synergia/synermycha-electronics/README.md

View this project on [CADLAB.io](https://cadlab.io/project/23388). 

# synermycha-electronics
