synergia/synermycha-electronics/3D_models/VL53L0X.STEP

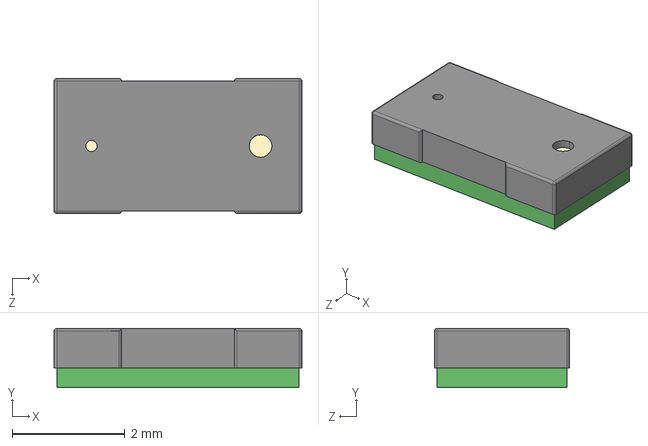
[picture p1: CAD file, 2020-03-10]
3D_models/VL53L0X.STEP
4.40 x 1.05 x 2.40 mm
