synergia/synermycha-electronics/as5045b_board/as5045b_board_left.step

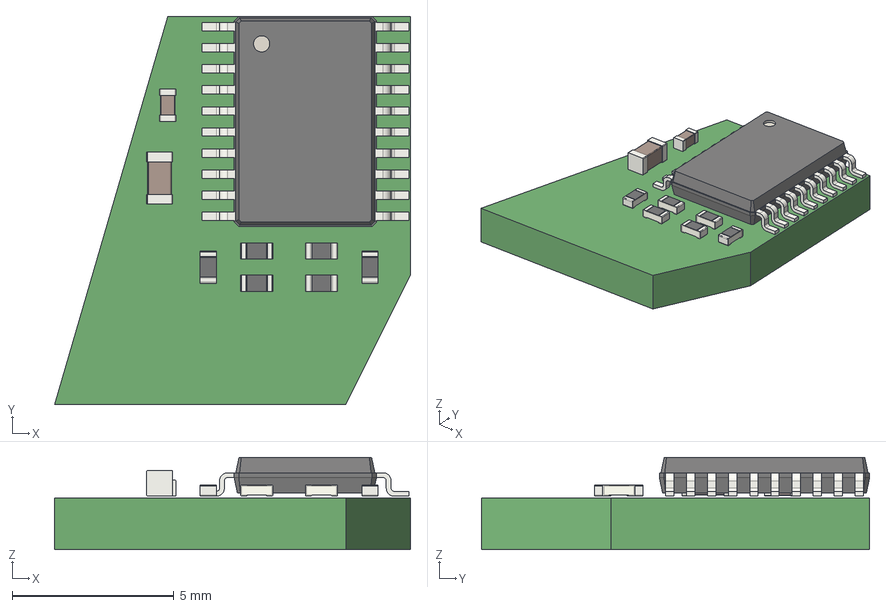
[picture p2: CAD file, 2020-03-10]
as5045b_board/as5045b_board_left.step
11.0 x 12.0 x 2.85 mm
