synergia/synermycha-electronics/3D_models/SynerMycha-silnikii.stp

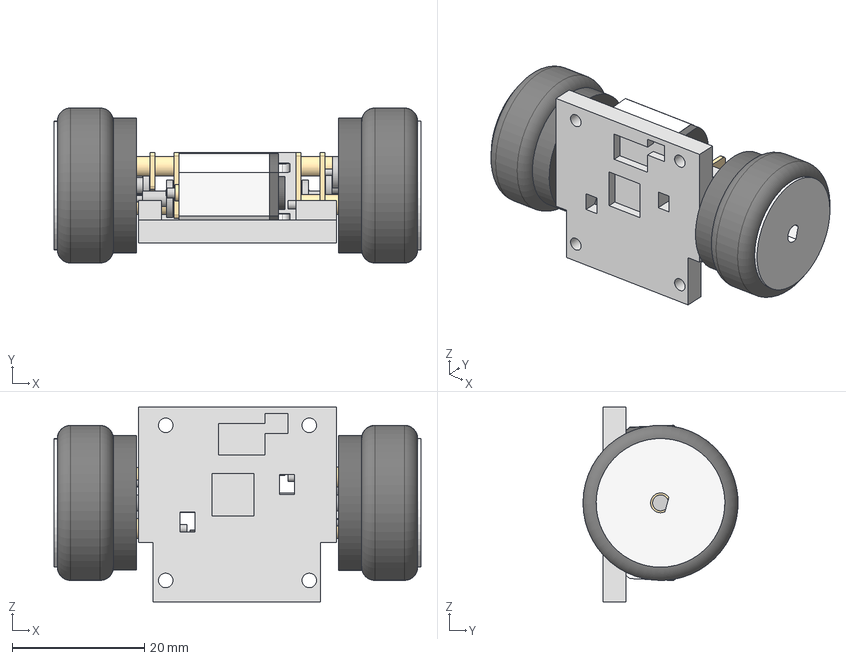
[picture p3: CAD file, 2020-03-10]
3D_models/SynerMycha-silnikii.stp
55.6 x 23.5 x 29.5 mm
GearboxScaffolding x 2
DC Motor x 2
Felga x 2
Tyre x 2
MWR0032KAC-KH x 2
podstawa_silnikó
