synergia/synermycha-electronics/vl53l0_board/vl53l0.STEP

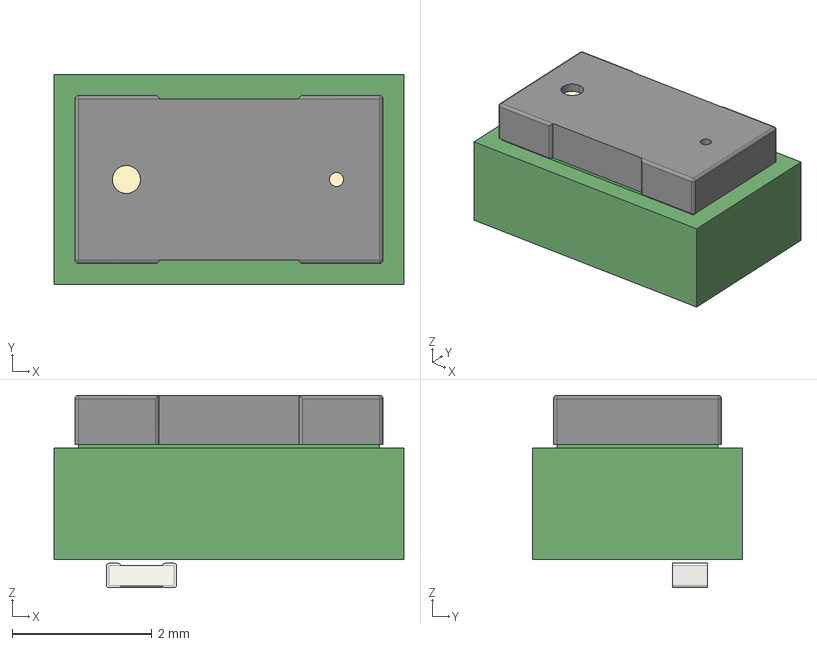
[picture p4: CAD file, 2020-03-10]
vl53l0_board/vl53l0.STEP
5.00 x 3.00 x 2.75 mm
