synergia/synermycha-electronics/3D_models/FTSH-107-01-L-DV-K-TR.stp

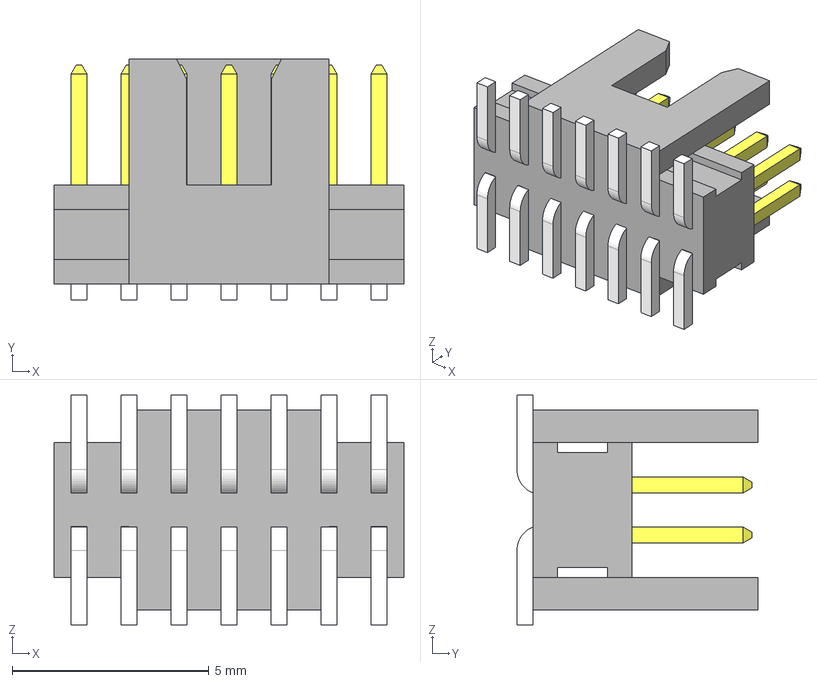
[picture p5: CAD file, 2020-03-10]
3D_models/FTSH-107-01-L-DV-K-TR.stp
8.89 x 6.12 x 5.84 mm
_FTSH-107-01-L-DV-K-TR_body
_FTSH-107-01-L-DV-K-TR_pins1
_FTSH-107-01-L-DV-K-TR_pins2
