synergia/synermycha-electronics/3D_models/User Library-R-PWSON-N12.step

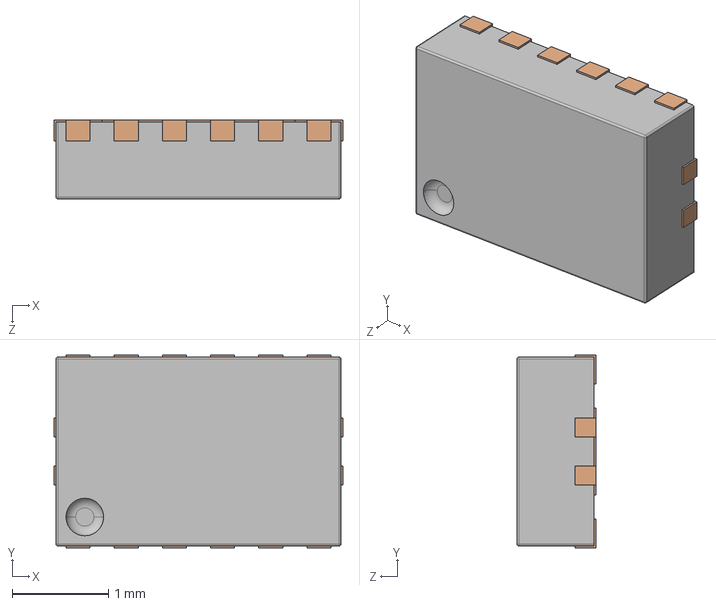
[picture p6: CAD file, 2020-03-10]
3D_models/User Library-R-PWSON-N12.step
3.00 x 2.00 x 0.82 mm
