synergia/synermycha-electronics/3D_models/MPU9250.step

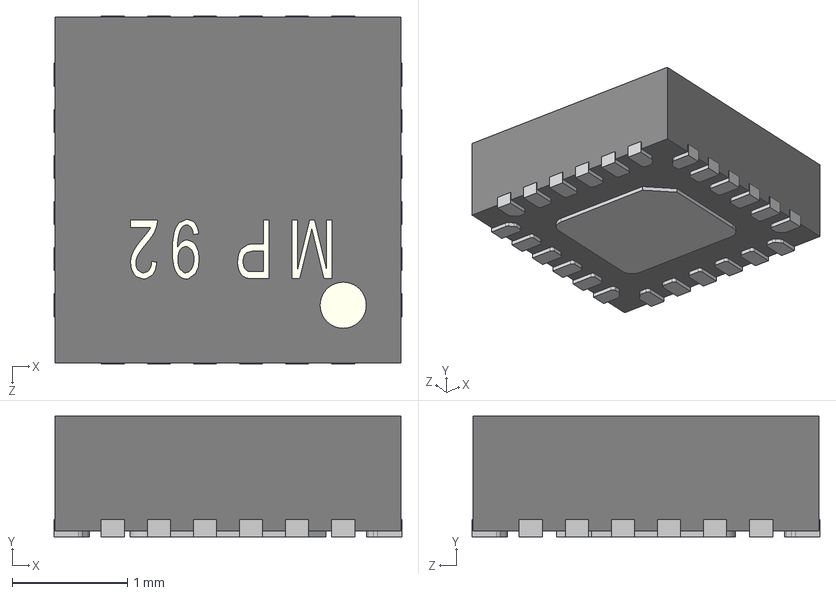
[picture p7: CAD file, 2020-03-10]
3D_models/MPU9250.step
3.02 x 1.05 x 3.02 mm
