synergia/synermycha-electronics/3D_models/CMT-5023S-SMT-TR.stp

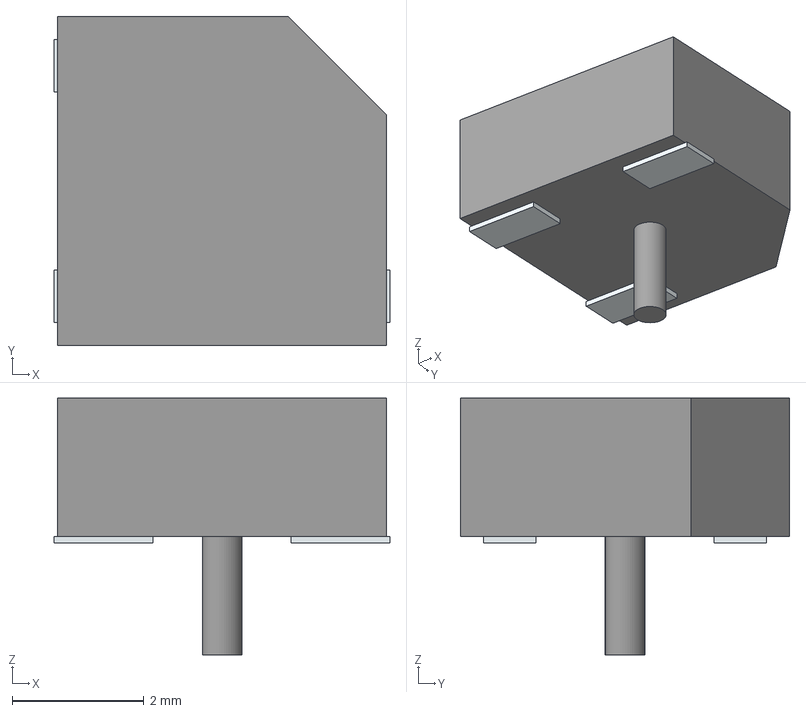
[picture p8: CAD file, 2020-03-10]
3D_models/CMT-5023S-SMT-TR.stp
5.10 x 5.00 x 3.90 mm
('pin',_'1')
('pin',_'2')
('pin',_'3')
lug1
