synergia/synermycha-electronics/3D_models/ABM8G-12.000MHZ-4Y-T3--3DModel-STEP-56544.STEP

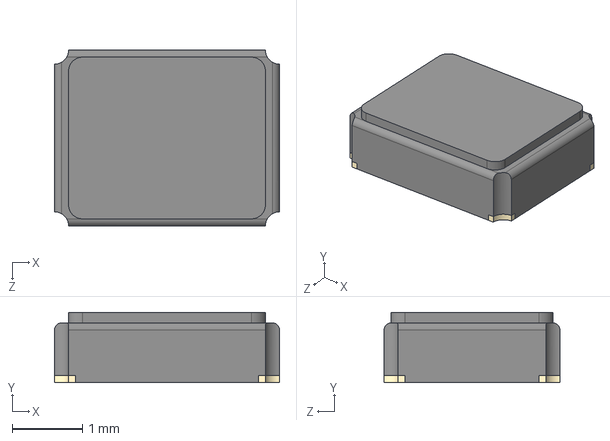
[picture p9: CAD file, 2020-03-10]
3D_models/ABM8G-12.000MHZ-4Y-T3--3DModel-STEP-56544.STEP
3.20 x 1.00 x 2.50 mm
