synergia/synermycha-electronics/3D_models/DF13C-4P-1.25V.step

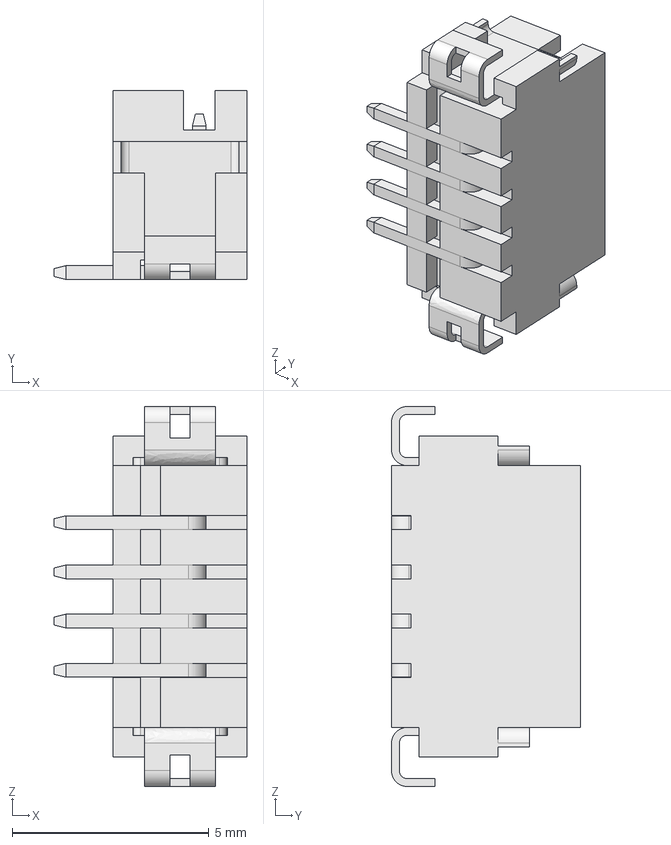
[picture p10: CAD file, 2020-03-10]
3D_models/DF13C-4P-1.25V.step
4.90 x 4.80 x 9.65 mm
