synergia/synermycha-electronics/3D_models/WS2812-2020.stp

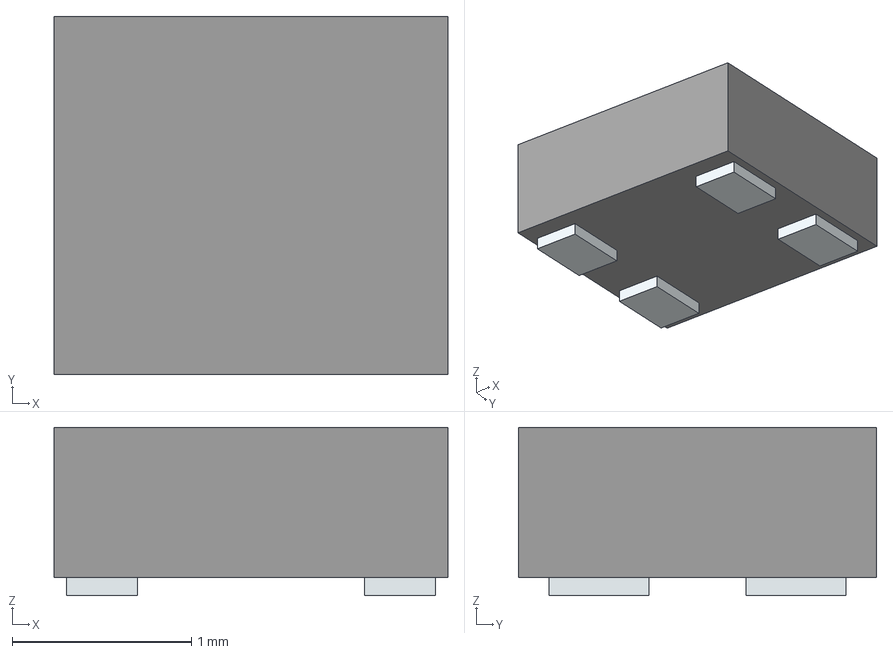
[picture p11: CAD file, 2020-03-10]
3D_models/WS2812-2020.stp
2.20 x 2.00 x 0.94 mm
('pin',_'1')
('pin',_'2')
('pin',_'3')
('pin',_'4')
