synergia/synermycha-electronics/3D_models/mocowanie-napędów.stp

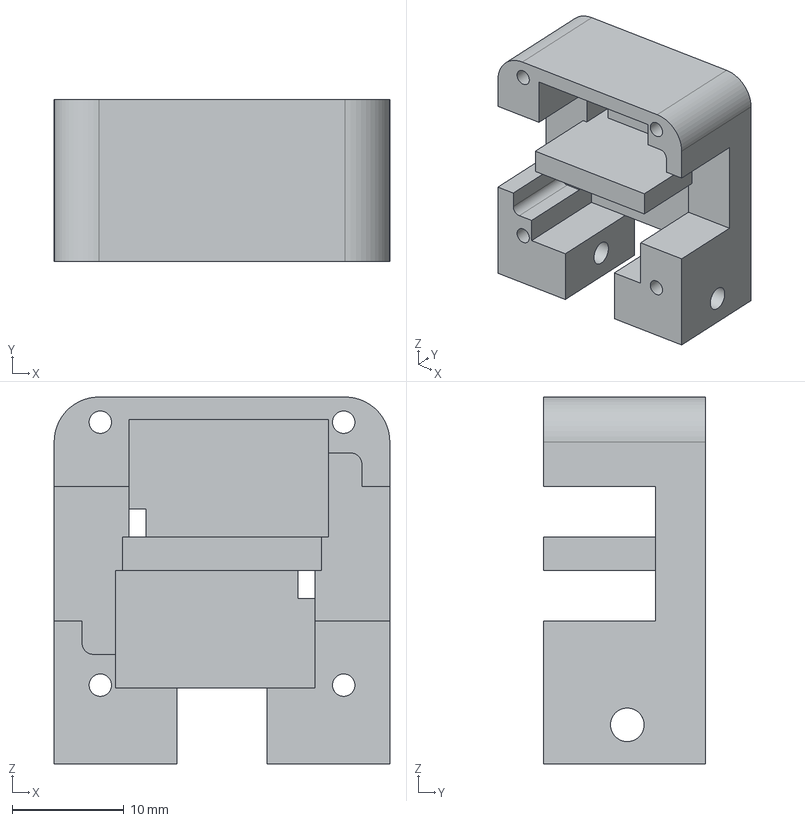
[picture p12: CAD file, 2020-03-10]
3D_models/mocowanie-napędów.stp
30.0 x 14.5 x 32.8 mm
