synergia/synermycha-electronics/3D_models/JS102011SAQN.STEP

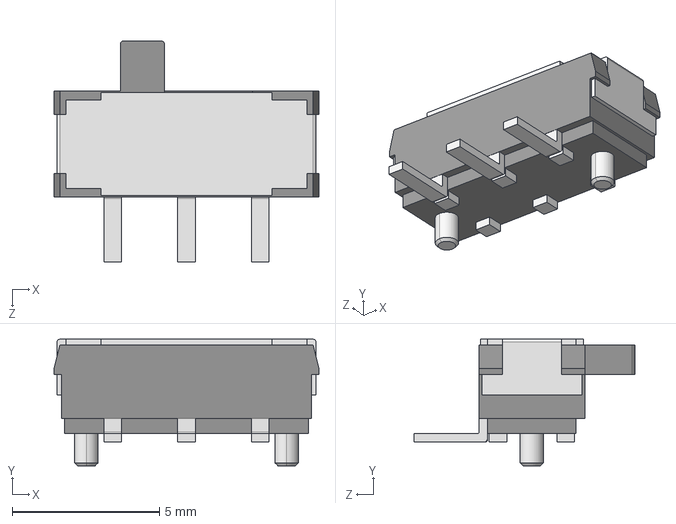
[picture p13: CAD file, 2020-03-10]
3D_models/JS102011SAQN.STEP
9.00 x 4.30 x 7.50 mm
