synergia/synermycha-electronics/(list of files, cad)

Other CAD files:
as5045b_board/as5045b_board_right.step
