synergia/synermycha-electronics/(threads)

Thread 1 (2020-03-07):

FSYNC pin wisi

bartek1333, 2020-03-07:
W DS do IMU:
FSYNC Frame synchronization digital input. Connect to GND if unused.
Na schemacie wisi

Frzoen, 2020-03-07:
Fixed in [commit](https://github.com/synergia/synermycha-electronics/commit/8cd587369a88bf1a04ddcbafc6c34fccc7df5dc4)

Closed 2020-03-07.

Thread 11 (2020-03-07):

Dodatkowy kondensator 100uF na linii 6V

bartek1333, 2020-03-07:
Trzeba dodać kondensator 100nF (z DS) do pinu VM

Frzoen, 2020-03-07:
Fixed in [https://github.com/synergia/synermycha-electronics/commit/8cd587369a88bf1a04ddcbafc6c34fccc7df5dc4](commit)

bartek1333, 2020-03-08:
In DS example is 100nF, not 100uF

Frzoen, 2020-03-08:
Na przykładowym układzie nie ma nic o 0.1uF na VM. 0.1uF nic nie da na wejściu mostka, za duże prądy przepływają. Można pomyśleć nad jakimiś kondensatorami na pinach silników. 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

bartek1333, 2020-03-08:
Nie wiem co to jest za przykładowy schemat, ale ten poniżej jest z DS:
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

Frzoen, 2020-03-08:
Fixed in [commit](https://github.com/synergia/synermycha-electronics/commit/1e9b78f6cea6090ee7997e9f168c55b7f5af0730)

Closed 2020-03-08.

Thread 12 (2020-03-07):

Połączenie z czujnikiem XSHUT

bartek1333, 2020-03-07:
W sumie o tym już gadaliśmy, ale napisze. Procek powinien na spokojnie sterować pinem xshut nawet jeśli jest podłączony do 2.8V (zwierać do masy w trybie open drain).
Odpada wtedy 1 rezystor i 2 napięcia koło siebie na jednej linii

Frzoen, 2020-03-07:
DS do VC53L0x zaleca napięcie 2.8 i napięcie na pinach XSHUT powinno być takie jak zasilające. Poza tym można pominąć wlutowanie rezystorów i zastąpić je 0R i wyjdzie na to samo.

bartek1333, 2020-03-07:
Który rezystor chcesz zastąpić przez 0R że wyjdzie to samo?
Jak będzie open drain i rezystor do 2.8V, to będzie zgodnie z DS, 0-2.8

Frzoen, 2020-03-07:
Zwarcie padów dwóch rezystorów. Da się wykonać w obecnym układnie

bartek1333, 2020-03-07:
Tak czy inaczej, będzie to trzeba sterować z open drain, a nie push-pull, bo na xshut pójdzie 3.3. Więc po co kombinować z dwoma napięciami.

Frzoen, 2020-03-07:
Wontfix

bartek1333, 2020-03-07:
Sam napisałeś że tam ma być 2.8V.
Sprawdź w symulacji, że tam wyjdzie 3.3

Frzoen, 2020-03-07:
Wciąż, da się wykonać na aktualnym schemacie, przykładowo R38 0R albo zwora. Ten układ jest w dokumentacji do modułów Polulu z którymi Arduino 5V czy Nucleo 3V3 bez problemu się komunikują.

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

bartek1333, 2020-03-08:
Co Ci da zastąpienie R38 zworą czy 0R?

Cytat ze strony https://www.pololu.com/product/2490

The XSHUT pin is an input and the GPIO1 pin is an open-drain output; both pins are pulled up to 2.8 V by the board. They are not connected to level-shifters on the board and are not 5V-tolerant, but they are usable as-is with many 3.3 V and 5 V microcontrollers: the microcontroller can read the GPIO1 output as long as its logic high threshold is below 2.8 V, and the microcontroller can alternate its own output between low and high-impedance states to drive the XSHUT pin. Alternatively, our 4-channel bidirectional logic level shifter can be used externally with those pins.

Więc komunikują się z nim procki 3.3V i 5V tylko dlatego, że ma wbudowany na liniach I2C logic level shifter. Natomiast już sterowanie pinem XSHOUT nie jest takie proste bo na płytce (i na naszym schemacie) nie ma konwertera napięć. I jedyne co procek może zrobić to zwierać do GND lub wisieć w powietrzu, żeby nie dać 3.3 lub 5V na układ.
Dlatego to 3.3V tam nie powinno być, bo w symulacji wychodzi, że na XSHOUT będzie szło 3.3V gdy na wyjściu procka będzie logiczne 1 (push pull). Przy open drain bez ściągania do masy, też na xshout będzie ponad 3V.

Dlatego to 3.3V trzeba usunąć. Procki o których pisałeś komunikują się z tym, nie wystawiając 1-0 na linie, tylko zwierając albo do masy, albo float.

Frzoen, 2020-03-08:
Fixed in [commit](https://github.com/synergia/synermycha-electronics/commit/1e9b78f6cea6090ee7997e9f168c55b7f5af0730)

Closed 2020-03-08.

Thread 2 (2020-03-07):

CS pin

bartek1333, 2020-03-07:
Pin CS jest do vdd bezpośrednio w DS, na schemacie przez rezystorem

Frzoen, 2020-03-07:
Rezystor zabezpiecza układ. Dobra praktyka - podciąganie do VCC/GND za pomocą rezystora

Closed 2020-03-07.

Thread 3 (2020-03-07):

RESVCC RESGND

bartek1333, 2020-03-07:
Piny resv_GDN wisi a powinno być do GND, tak samo Res_VCC do vcc

Frzoen, 2020-03-07:
Fixed in [commit](https://github.com/synergia/synermycha-electronics/commit/8cd587369a88bf1a04ddcbafc6c34fccc7df5dc4)

Closed 2020-03-07.

Thread 4 (2020-03-07):

pull up I2C

bartek1333, 2020-03-07:
Pull-Up dla 3.3V ok 2k7, nie 10k. Nad 2.8V trzeba rozkminić

Frzoen, 2020-03-07:
2K7 będzie dobre też dla 2.8V a nie dodajemy kolejnej wielkości rezystora do BOM

Frzoen, 2020-03-07:
Fixed in [commit](https://github.com/synergia/synermycha-electronics/commit/8cd587369a88bf1a04ddcbafc6c34fccc7df5dc4)

Closed 2020-03-07.

Thread 6 (2020-03-07):

zamiana polaryzacji led przy VL53L0

bartek1333, 2020-03-07:
Zmienić na schemacie polaryzacje diody przy czujnikach. Niby to schemat, ale niech już będzie ok xD

Frzoen, 2020-03-07:
Fixed in [commit](https://github.com/synergia/synermycha-electronics/commit/8cd587369a88bf1a04ddcbafc6c34fccc7df5dc4)

Closed 2020-03-07.

Thread 8 (2020-03-07):

zmiana wartości rezystora przy LM1117 6V

bartek1333, 2020-03-07:
Policzyłem i bliższą wartością dla 6V na wyjściu, będzie wstawienie zamiast 3k16, to 3k32 z szeregu E192 (0.5%)

Frzoen, 2020-03-07:
Fixed in [commit](https://github.com/synergia/synermycha-electronics/commit/8cd587369a88bf1a04ddcbafc6c34fccc7df5dc4)

Closed 2020-03-07.

Thread 13 (2020-03-09):

Brak pull-up na XSHOUT

bartek1333, 2020-03-09:
Dołożyć pull up na 2.8V na każdy xshout

Frzoen, 2020-03-10:
Fixed in [commit](https://github.com/synergia/synermycha-electronics/commit/6721a22e7ced20e5ca89c9b0f47a4a8e833ebf07)

Closed 2020-03-10.

Thread 14 (2020-03-10):

Odwrotna polaryzacja diody  LED_MOUSE_EYE

bartek1333, 2020-03-10:
Jak w temacie

Frzoen, 2020-03-10:
Fixed in [commit](https://github.com/synergia/synermycha-electronics/tree/3e133a07d852ece3ec825dd7d51c8af7a5921581)

Closed 2020-03-10.
