synergia/synermycha-electronics/synermycha-electronics.kicad_pcb

## KiCad design synermycha-electronics.kicad_pcb (2020-08-28)

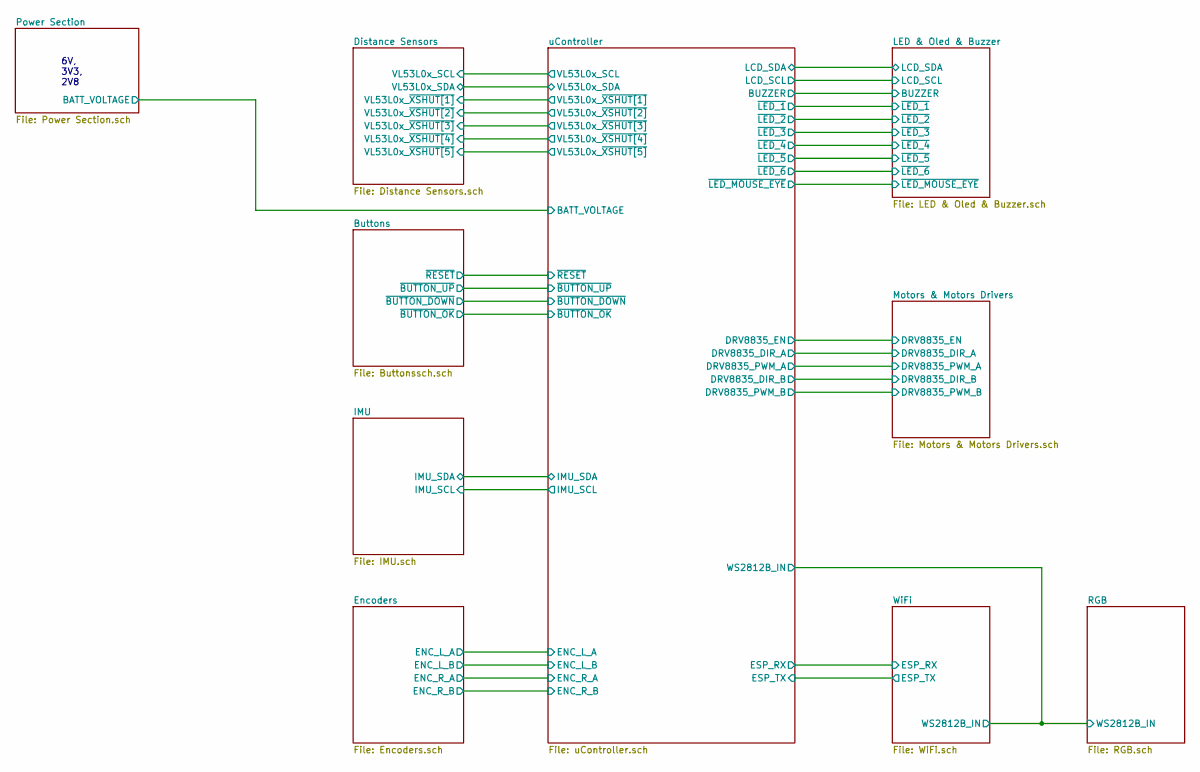
[picture p14: schematic synermycha-electronics.sch]

Notes on the sheet:
6V, 3V3, 2V8

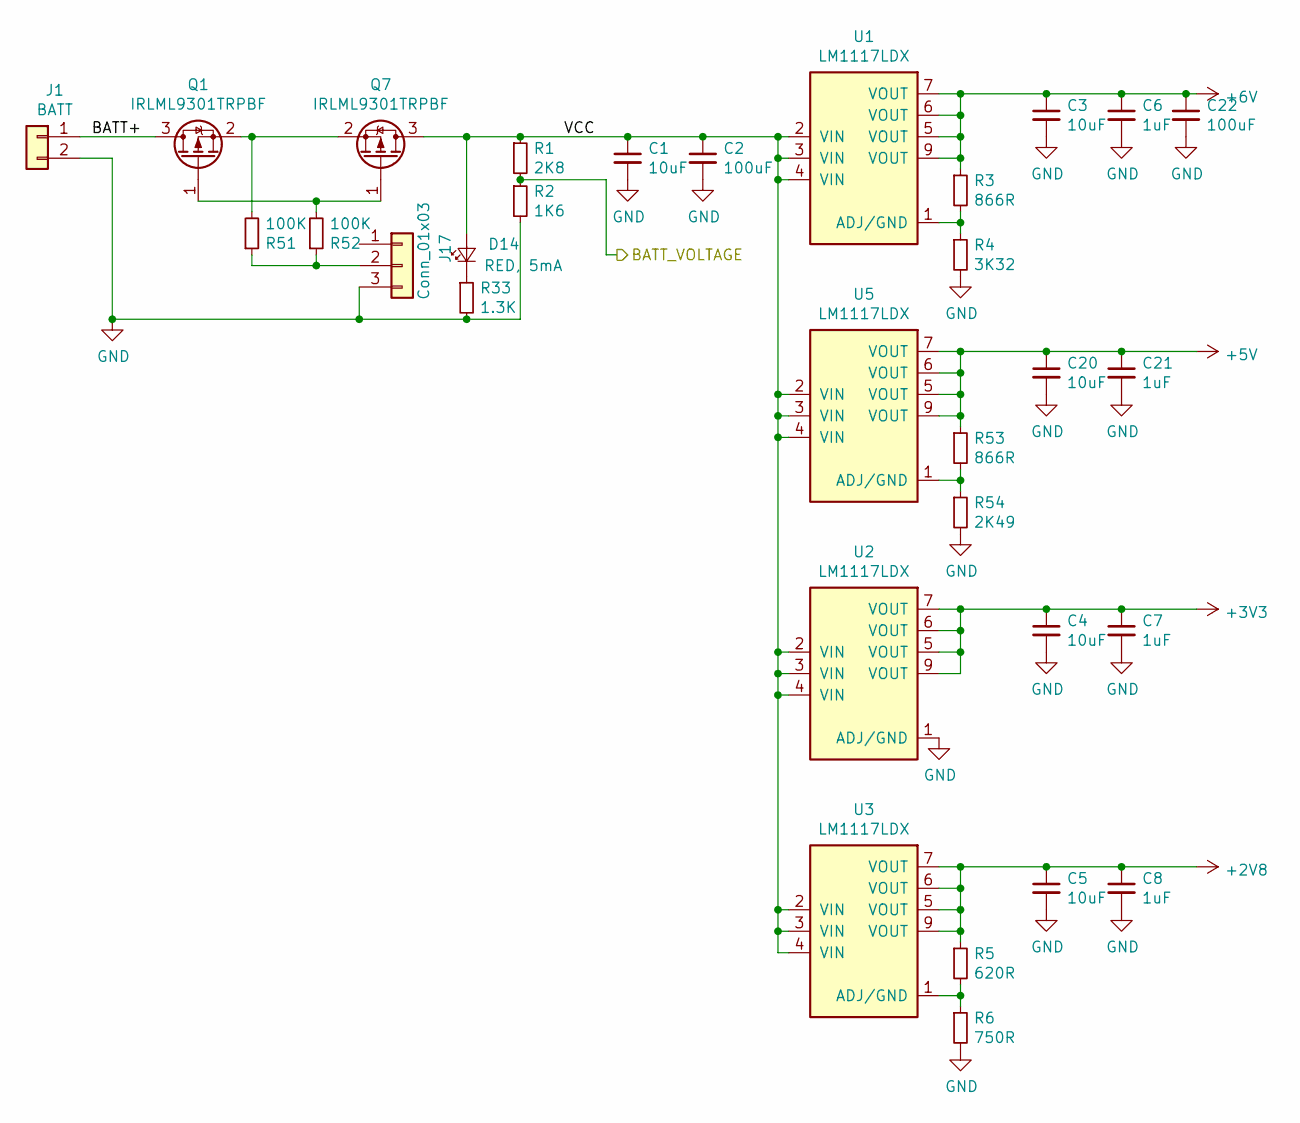
[picture p15: schematic Power Section.sch]

Parts:
C1, C3, C4, C5, C20: 10uF; C_0603_1608Metric
C2, C22: 100uF; C_0805_2012Metric
C6, C7, C8, C21: 1uF; C_0402_1005Metric
D14: RED, 5mA; LED_0402_1005Metric
J1: BATT; PinHeader_1x02_P2.54mm_Vertical
J17: Conn_01x03; SW_SPDT_CK-JS102011SAQN
Q1, Q7: IRLML9301TRPBF; SOT-23
R1: 2K8; R_0402_1005Metric
R2: 1K6; R_0402_1005Metric
R3, R53: 866R; R_0402_1005Metric
R4: 3K32; R_0402_1005Metric
R5: 620R; R_0402_1005Metric
R6: 750R; R_0402_1005Metric
R33: 1.3K; R_0402_1005Metric
R51, R52: 100K; R_0402_1005Metric
R54: 2K49; R_0402_1005Metric
U1, U2, U3, U5: LM1117LDX; WSON-8_4x4mm_P0.8mm

Connections:
+2V8: C5.1, C8.1, R5.1, U3.5 (VOUT), U3.6 (VOUT), U3.7 (VOUT), U3.9 (VOUT); also elsewhere on the board
+3V3: C4.1, C7.1, U2.5 (VOUT), U2.6 (VOUT), U2.7 (VOUT), U2.9 (VOUT); also elsewhere on the board
+5V: C20.1, C21.1, R53.1, U5.5 (VOUT), U5.6 (VOUT), U5.7 (VOUT), U5.9 (VOUT); also elsewhere on the board
+6V: C3.1, C6.1, C22.1, R3.1, U1.5 (VOUT), U1.6 (VOUT), U1.7 (VOUT), U1.9 (VOUT); also elsewhere on the board
/Power Section/BATT+: J1.1, Q1.3 (D)
/Power Section/BATT_VOLTAGE: R1.2, R2.1; also elsewhere on the board
/Power Section/VCC: C1.1, C2.1, D14.2 (A), Q7.3 (D), R1.1, U1.2 (VIN), U1.3 (VIN), U1.4 (VIN), U2.2 (VIN), U2.3 (VIN), U2.4 (VIN), U3.2 (VIN), U3.3 (VIN), U3.4 (VIN), U5.2 (VIN), U5.3 (VIN), U5.4 (VIN)
GND: C1.2, C2.2, C3.2, C4.2, C5.2, C6.2, C7.2, C8.2, C20.2, C21.2, C22.2, J1.2, J17.3, R2.2, R4.2, R6.2, R33.2, R54.2, U2.1 (ADJ/GND); also elsewhere on the board
unnamed: D14.1 (K), R33.1
unnamed: J17.2, R51.1, R52.1
unnamed: Q1.1 (G), Q7.1 (G), R52.2
unnamed: Q1.2 (S), Q7.2 (S), R51.2
unnamed: R3.2, R4.1, U1.1 (ADJ/GND)
unnamed: R5.2, R6.1, U3.1 (ADJ/GND)
unnamed: R53.2, R54.1, U5.1 (ADJ/GND)

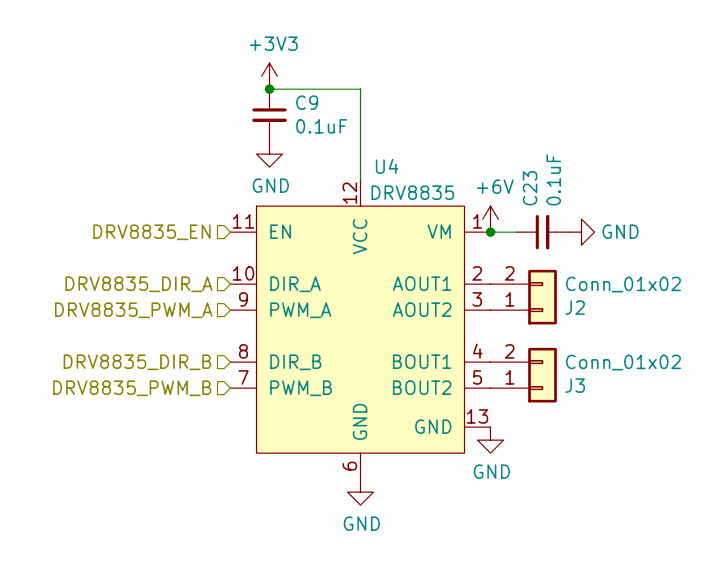
[picture p16: schematic Motors & Motors Drivers.sch]

Parts:
C9, C23: 0.1uF; C_0402_1005Metric
J2, J3: Conn_01x02; PinHeader_1x02_P1.00mm_Vertical
U4: DRV8835; WSON-12-1EP_3x2mm_P0.5mm_EP1x2.65

Connections:
+3V3: C9.1, U4.12 (VCC); also elsewhere on the board
+6V: C23.1, U4.1 (VM); also elsewhere on the board
/Motors & Motors Drivers/DRV8835_DIR_A: U4.10 (DIR_A); also elsewhere on the board
/Motors & Motors Drivers/DRV8835_DIR_B: U4.8 (DIR_B); also elsewhere on the board
/Motors & Motors Drivers/DRV8835_EN: U4.11 (EN); also elsewhere on the board
/Motors & Motors Drivers/DRV8835_PWM_A: U4.9 (PWM_A); also elsewhere on the board
/Motors & Motors Drivers/DRV8835_PWM_B: U4.7 (PWM_B); also elsewhere on the board
GND: C9.2, C23.2, U4.6 (GND), U4.13 (GND); also elsewhere on the board
unnamed: J2.1, U4.3 (AOUT2)
unnamed: J2.2, U4.2 (AOUT1)
unnamed: J3.1, U4.5 (BOUT2)
unnamed: J3.2, U4.4 (BOUT1)

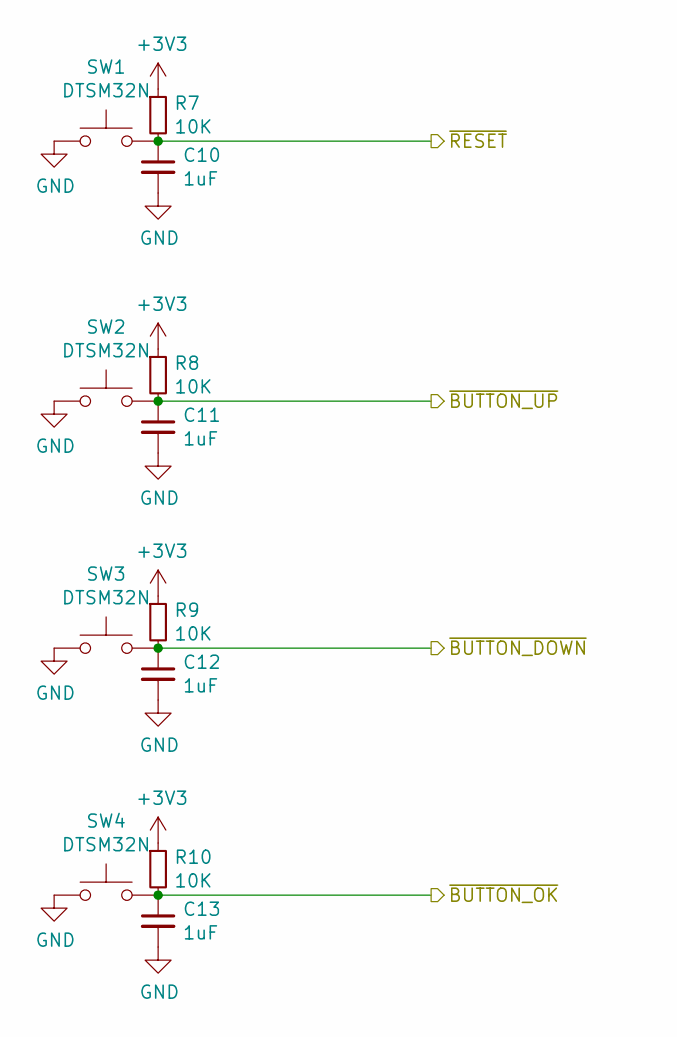
[picture p17: schematic Buttonssch.sch]

Parts:
C10, C11, C12, C13: 1uF; C_0402_1005Metric
R7, R8, R9, R10: 10K; R_0402_1005Metric
SW1, SW2, SW3, SW4: DTSM32N; SW_SPST_B3U-1000P

Connections:
+3V3: R7.1, R8.1, R9.1, R10.1; also elsewhere on the board
/Buttons/~BUTTON_DOWN: C12.1, R9.2, SW3.2; also elsewhere on the board
/Buttons/~BUTTON_OK: C13.1, R10.2, SW4.2; also elsewhere on the board
/Buttons/~BUTTON_UP: C11.1, R8.2, SW2.2; also elsewhere on the board
/Buttons/~RESET: C10.1, R7.2, SW1.2; also elsewhere on the board
GND: C10.2, C11.2, C12.2, C13.2, SW1.1, SW2.1, SW3.1, SW4.1; also elsewhere on the board

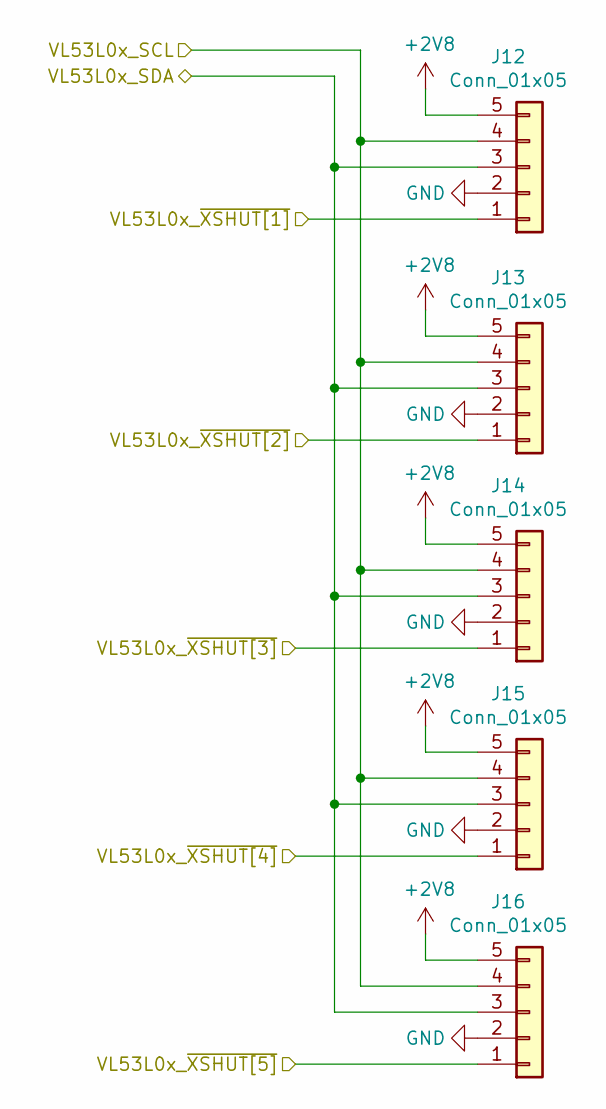
[picture p18: schematic Distance Sensors.sch]

Parts:
J12, J13, J14, J15, J16: Conn_01x05; 01x05_1.0x0.5mm_SMD

Connections:
+2V8: J12.5, J13.5, J14.5, J15.5, J16.5; also elsewhere on the board
/Distance Sensors/VL53L0x_SCL: J12.4, J13.4, J14.4, J15.4, J16.4; also elsewhere on the board
/Distance Sensors/VL53L0x_SDA: J12.3, J13.3, J14.3, J15.3, J16.3; also elsewhere on the board
/Distance Sensors/VL53L0x_~XSHUT[1]: J12.1; also elsewhere on the board
/Distance Sensors/VL53L0x_~XSHUT[2]: J13.1; also elsewhere on the board
/Distance Sensors/VL53L0x_~XSHUT[3]: J14.1; also elsewhere on the board
/Distance Sensors/VL53L0x_~XSHUT[4]: J15.1; also elsewhere on the board
/Distance Sensors/VL53L0x_~XSHUT[5]: J16.1; also elsewhere on the board
GND: J12.2, J13.2, J14.2, J15.2, J16.2; also elsewhere on the board

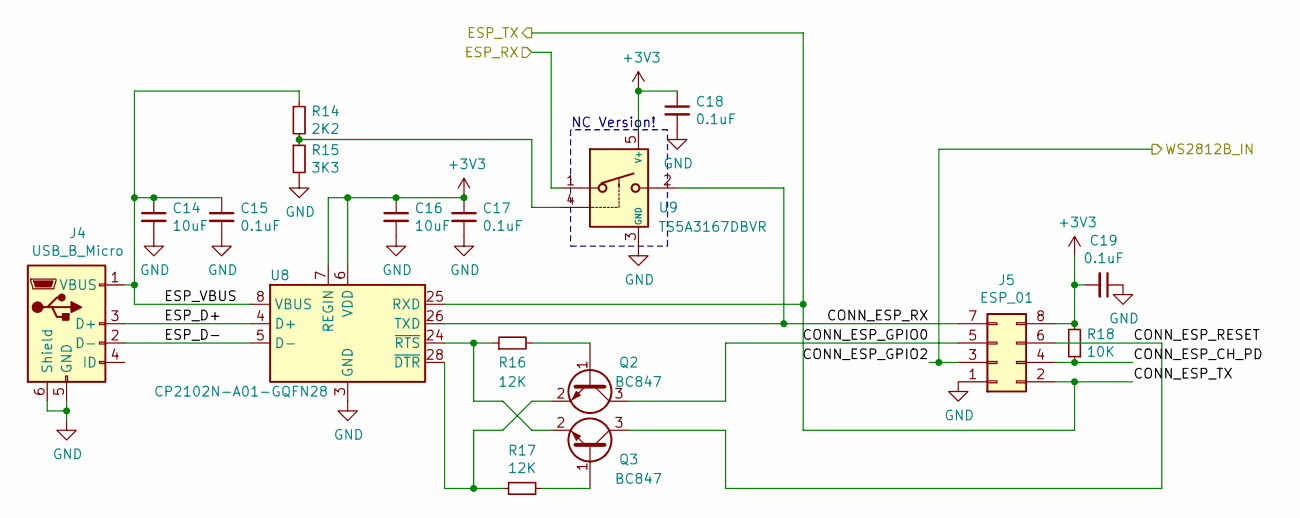
[picture p19: schematic WiFi.sch]

Parts:
C14, C16: 10uF; C_0603_1608Metric
C15, C17, C18, C19: 0.1uF; C_0402_1005Metric
J4: USB_B_Micro; USB_Micro-B_Amphenol_10103594-0001LF_Horizontal
J5: ESP_01; PinSocket_2x04_P2.54mm_Vertical_SMD
Q2, Q3: BC847; SOT-23
R14: 2K2; R_0402_1005Metric
R15: 3K3; R_0402_1005Metric
R16, R17: 12K; R_0402_1005Metric
R18: 10K; R_0402_1005Metric
U8: CP2102N-A01-GQFN28; QFN-28-1EP_5x5mm_P0.5mm_EP3.35x3.35mm
U9: TS5A3167DBVR; SOT-23-5

Connections:
+3V3: C16.1, C17.1, C18.1, C19.2, J5.8, R18.2, U8.6 (VDD), U8.7 (REGIN), U9.5 (V+); also elsewhere on the board
/RGB/WS2812B_IN: J5.3; also elsewhere on the board
/WiFi/CONN_ESP_CH_PD: J5.4, R18.1
/WiFi/CONN_ESP_GPIO0: J5.5, Q2.3 (C)
/WiFi/CONN_ESP_RESET: J5.6, Q3.3 (C)
/WiFi/CONN_ESP_RX: J5.7, U8.26 (TXD), U9.2
/WiFi/ESP_D+: J4.3 (D+), U8.4 (D+)
/WiFi/ESP_D-: J4.2 (D-), U8.5 (D-)
/WiFi/ESP_RX: U9.1; also elsewhere on the board
/WiFi/ESP_TX: J5.2, U8.25 (RXD); also elsewhere on the board
/WiFi/ESP_VBUS: C14.1, C15.1, J4.1 (VBUS), R14.1, U8.8 (VBUS)
GND: C14.2, C15.2, C16.2, C17.2, C18.2, C19.1, J4.5 (GND), J4.6 (Shield), J5.1, R15.2, U8.3 (GND), U9.3 (GND); also elsewhere on the board
unnamed: Q2.1 (B), R16.2
unnamed: Q2.2 (E), R17.1, U8.28 (~DTR)
unnamed: Q3.1 (B), R17.2
unnamed: Q3.2 (E), R16.1, U8.24 (~RTS)
unnamed: R14.2, R15.1, U9.4

Notes on the sheet:
NC Version!

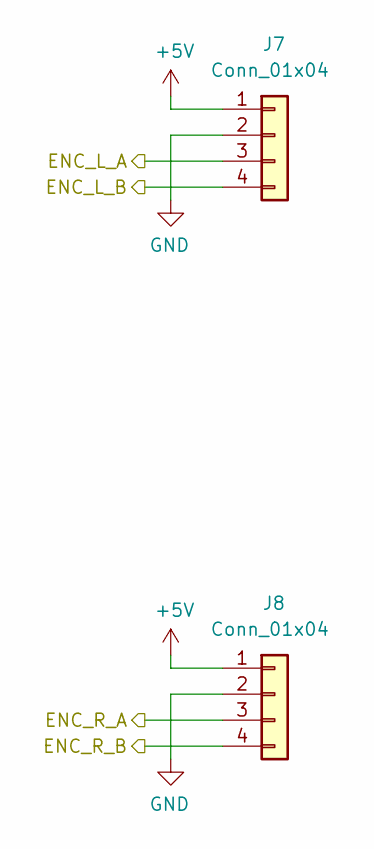
[picture p20: schematic Encoders.sch]

Parts:
J7, J8: Conn_01x04; 01x04_1.0x0.5mm_SMD

Connections:
+5V: J7.1, J8.1; also elsewhere on the board
/Encoders/ENC_L_A: J7.3; also elsewhere on the board
/Encoders/ENC_L_B: J7.4; also elsewhere on the board
/Encoders/ENC_R_A: J8.3; also elsewhere on the board
/Encoders/ENC_R_B: J8.4; also elsewhere on the board
GND: J7.2, J8.2; also elsewhere on the board

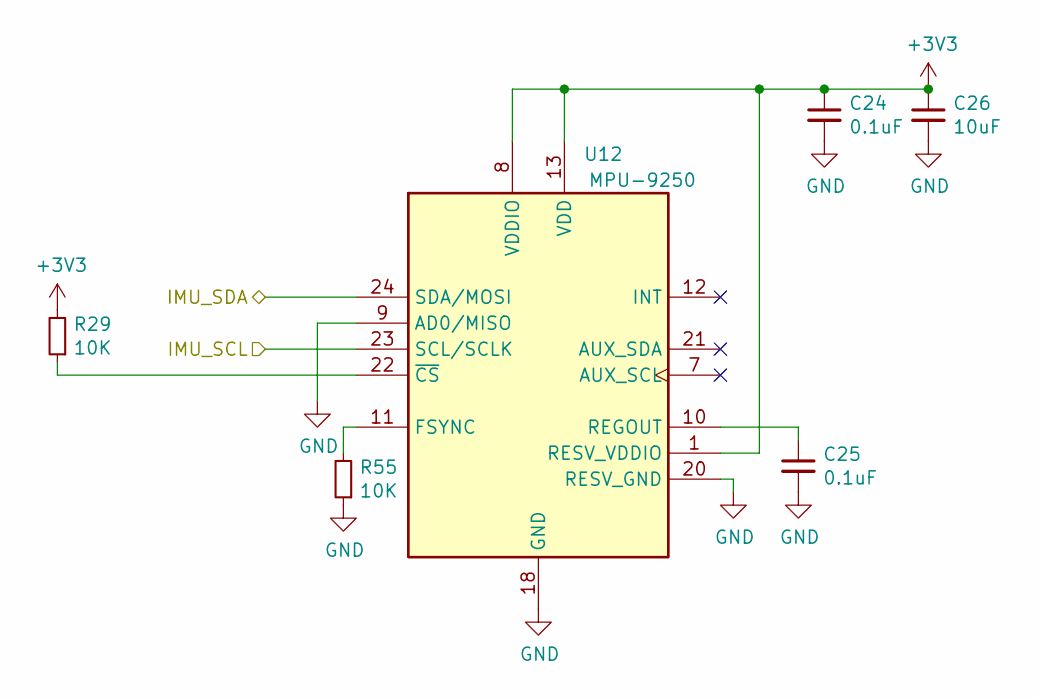
[picture p21: schematic IMU.sch]

Parts:
C24, C25: 0.1uF; C_0402_1005Metric
C26: 10uF; C_0603_1608Metric
R29, R55: 10K; R_0402_1005Metric
U12: MPU-9250; InvenSense_QFN-24_3x3mm_P0.4mm

Connections:
+3V3: C24.1, C26.1, R29.2, U12.1 (RESV_VDDIO), U12.8 (VDDIO), U12.13 (VDD); also elsewhere on the board
/IMU/IMU_SCL: U12.23 (SCL/SCLK); also elsewhere on the board
/IMU/IMU_SDA: U12.24 (SDA/MOSI); also elsewhere on the board
GND: C24.2, C25.2, C26.2, R55.1, U12.9 (AD0/MISO), U12.18 (GND), U12.20 (RESV_GND); also elsewhere on the board
unnamed: C25.1, U12.10 (REGOUT)
unnamed: R29.1, U12.22 (~CS)
unnamed: R55.2, U12.11 (FSYNC)

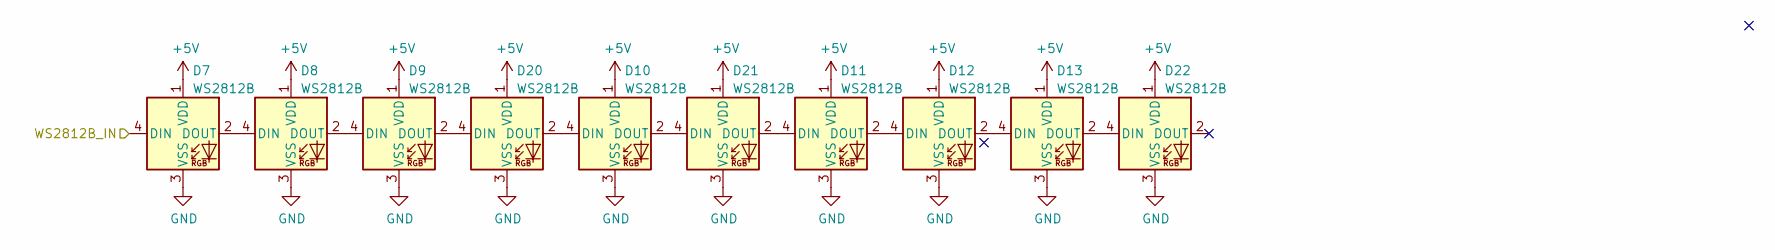
[picture p22: schematic RGB.sch]

Parts:
D7, D8, D9, D10, D11, D12, D13, D20, D21, D22: WS2812B; WS28122020

Connections:
+5V: D7.1 (VDD), D8.1 (VDD), D9.1 (VDD), D10.1 (VDD), D11.1 (VDD), D12.1 (VDD), D13.1 (VDD), D20.1 (VDD), D21.1 (VDD), D22.1 (VDD); also elsewhere on the board
/RGB/WS2812B_IN: D7.4 (DIN); also elsewhere on the board
GND: D7.3 (VSS), D8.3 (VSS), D9.3 (VSS), D10.3 (VSS), D11.3 (VSS), D12.3 (VSS), D13.3 (VSS), D20.3 (VSS), D21.3 (VSS), D22.3 (VSS); also elsewhere on the board
unnamed: D7.2 (DOUT), D8.4 (DIN)
unnamed: D8.2 (DOUT), D9.4 (DIN)
unnamed: D10.2 (DOUT), D21.4 (DIN)
unnamed: D10.4 (DIN), D20.2 (DOUT)
unnamed: D11.2 (DOUT), D12.4 (DIN)
unnamed: D11.4 (DIN), D21.2 (DOUT)
unnamed: D12.2 (DOUT), D13.4 (DIN)
unnamed: D13.2 (DOUT), D22.4 (DIN)
unnamed: D9.2 (DOUT), D20.4 (DIN)

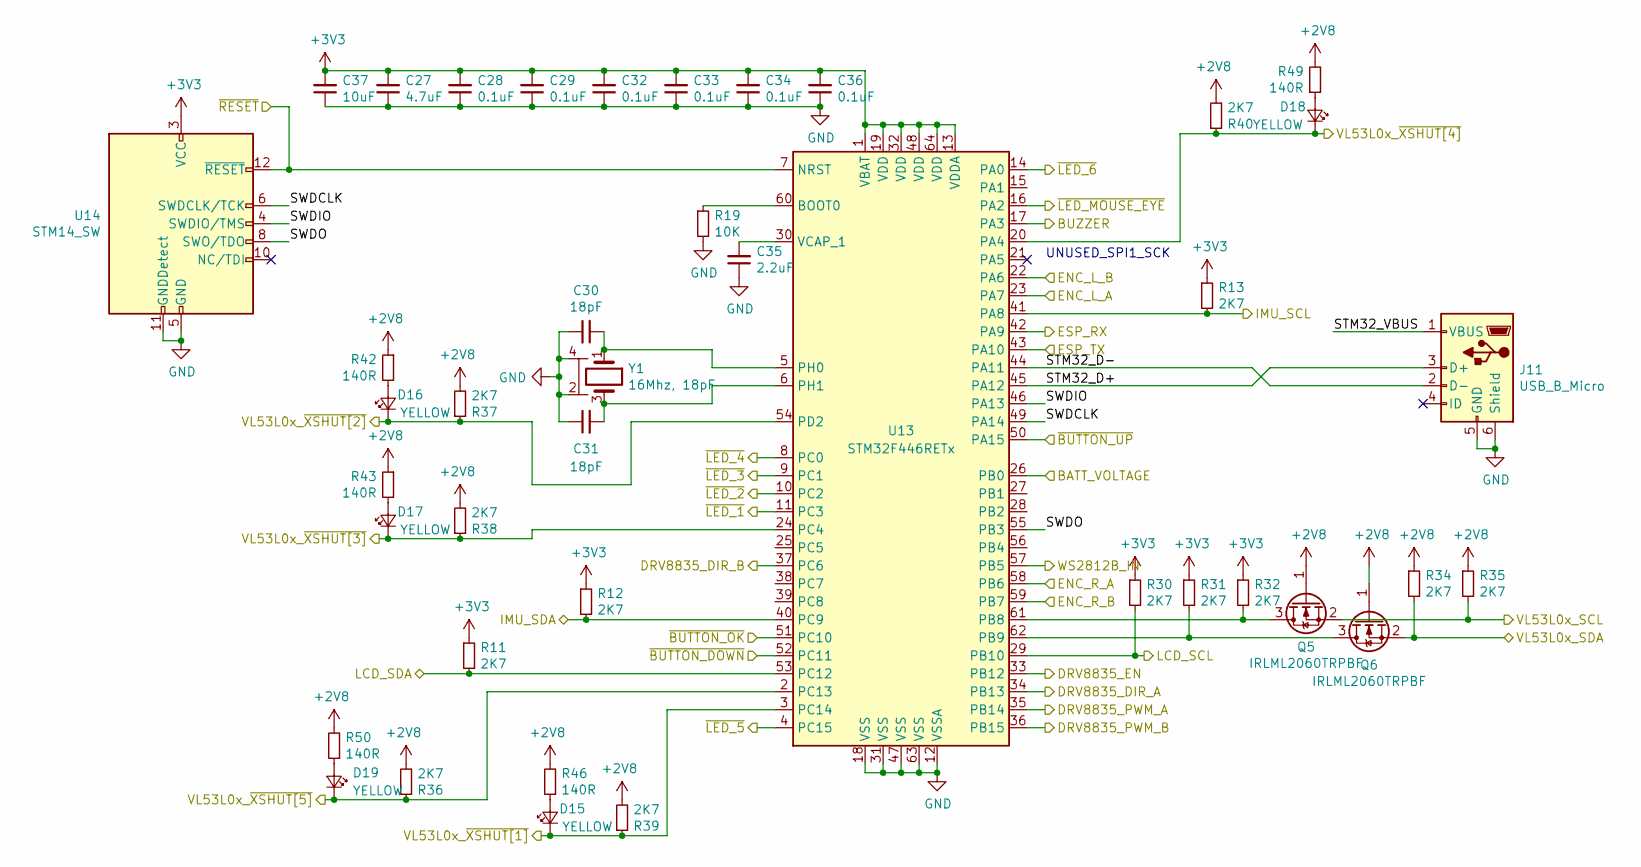
[picture p23: schematic uController.sch]

Parts:
C27: 4.7uF; C_0603_1608Metric
C28, C29, C32, C33, C34, C36: 0.1uF; C_0402_1005Metric
C30, C31: 18pF; C_0402_1005Metric
C35: 2.2uF; C_0603_1608Metric
C37: 10uF; C_0603_1608Metric
D15, D16, D17, D18, D19: YELLOW; LED_0402_1005Metric
J11: USB_B_Micro; USB_Micro-B_Amphenol_10103594-0001LF_Horizontal
Q5, Q6: IRLML2060TRPBF; SOT-23
R11, R12, R13, R30, R31, R32, R34, R35, R36, R37, R38, R39, R40: 2K7; R_0402_1005Metric
R19: 10K; R_0402_1005Metric
R42, R43, R46, R49, R50: 140R; R_0402_1005Metric
U13: STM32F446RETx; LQFP-64_10x10mm_P0.5mm
U14: STM14_SW; PinHeader_2x07_P1.27mm_Vertical_SMD
Y1: 16Mhz, 18pF; Crystal_SMD_Abracon_ABM8G-4Pin_3.2x2.5mm

Connections:
+2V8: Q5.1 (G), Q6.1 (G), R34.1, R35.1, R36.2, R37.2, R38.2, R39.2, R40.2, R42.1, R43.1, R46.2, R49.2, R50.2; also elsewhere on the board
+3V3: C27.2, C28.2, C29.2, C32.2, C33.2, C34.2, C36.2, C37.2, R11.1, R12.1, R13.1, R30.1, R31.1, R32.1, U13.1 (VBAT), U13.13 (VDDA), U13.19 (VDD), U13.32 (VDD), U13.48 (VDD), U13.64 (VDD), U14.3 (VCC); also elsewhere on the board
/Buttons/~BUTTON_DOWN: U13.52 (PC11); also elsewhere on the board
/Buttons/~BUTTON_OK: U13.51 (PC10); also elsewhere on the board
/Buttons/~BUTTON_UP: U13.50 (PA15); also elsewhere on the board
/Buttons/~RESET: U13.7 (NRST), U14.12 (~RESET~); also elsewhere on the board
/Distance Sensors/VL53L0x_SCL: Q5.2 (S), R35.2; also elsewhere on the board
/Distance Sensors/VL53L0x_SDA: Q6.2 (S), R34.2; also elsewhere on the board
/Distance Sensors/VL53L0x_~XSHUT[1]: D15.1 (K), R39.1, U13.3 (PC14); also elsewhere on the board
/Distance Sensors/VL53L0x_~XSHUT[2]: D16.1 (K), R37.1, U13.54 (PD2); also elsewhere on the board
/Distance Sensors/VL53L0x_~XSHUT[3]: D17.1 (K), R38.1, U13.24 (PC4); also elsewhere on the board
/Distance Sensors/VL53L0x_~XSHUT[4]: D18.1 (K), R40.1, U13.20 (PA4); also elsewhere on the board
/Distance Sensors/VL53L0x_~XSHUT[5]: D19.1 (K), R36.1, U13.2 (PC13); also elsewhere on the board
/Encoders/ENC_L_A: U13.23 (PA7); also elsewhere on the board
/Encoders/ENC_L_B: U13.22 (PA6); also elsewhere on the board
/Encoders/ENC_R_A: U13.58 (PB6); also elsewhere on the board
/Encoders/ENC_R_B: U13.59 (PB7); also elsewhere on the board
/IMU/IMU_SCL: R13.2, U13.41 (PA8); also elsewhere on the board
/IMU/IMU_SDA: R12.2, U13.40 (PC9); also elsewhere on the board
/LED & Oled & Buzzer/BUZZER: U13.17 (PA3); also elsewhere on the board
/LED & Oled & Buzzer/LCD_SCL: R30.2, U13.29 (PB10); also elsewhere on the board
/LED & Oled & Buzzer/LCD_SDA: R11.2, U13.53 (PC12); also elsewhere on the board
/LED & Oled & Buzzer/~LED_1: U13.11 (PC3); also elsewhere on the board
/LED & Oled & Buzzer/~LED_2: U13.10 (PC2); also elsewhere on the board
/LED & Oled & Buzzer/~LED_3: U13.9 (PC1); also elsewhere on the board
/LED & Oled & Buzzer/~LED_4: U13.8 (PC0); also elsewhere on the board
/LED & Oled & Buzzer/~LED_5: U13.4 (PC15); also elsewhere on the board
/LED & Oled & Buzzer/~LED_6: U13.14 (PA0); also elsewhere on the board
/LED & Oled & Buzzer/~LED_MOUSE_EYE: U13.16 (PA2); also elsewhere on the board
/Motors & Motors Drivers/DRV8835_DIR_A: U13.34 (PB13); also elsewhere on the board
/Motors & Motors Drivers/DRV8835_DIR_B: U13.37 (PC6); also elsewhere on the board
/Motors & Motors Drivers/DRV8835_EN: U13.33 (PB12); also elsewhere on the board
/Motors & Motors Drivers/DRV8835_PWM_A: U13.35 (PB14); also elsewhere on the board
/Motors & Motors Drivers/DRV8835_PWM_B: U13.36 (PB15); also elsewhere on the board
/Power Section/BATT_VOLTAGE: U13.26 (PB0); also elsewhere on the board
/RGB/WS2812B_IN: U13.57 (PB5); also elsewhere on the board
/WiFi/ESP_RX: U13.42 (PA9); also elsewhere on the board
/WiFi/ESP_TX: U13.43 (PA10); also elsewhere on the board
/uController/STM32_D+: J11.3 (D+), U13.45 (PA12)
/uController/STM32_D-: J11.2 (D-), U13.44 (PA11)
/uController/SWDCLK: U13.49 (PA14), U14.6 (SWDCLK/TCK)
/uController/SWDIO: U13.46 (PA13), U14.4 (SWDIO/TMS)
/uController/SWDO: U13.55 (PB3), U14.8 (SWO/TDO)
GND: C27.1, C28.1, C29.1, C30.2, C31.1, C32.1, C33.1, C34.1, C35.1, C36.1, C37.1, J11.5 (GND), J11.6 (Shield), R19.2, U13.12 (VSSA), U13.18 (VSS), U13.31 (VSS), U13.47 (VSS), U13.63 (VSS), U14.5 (GND), U14.11 (GNDDetect), Y1.2, Y1.4; also elsewhere on the board
unnamed: C30.1, U13.5 (PH0), Y1.1
unnamed: C31.2, U13.6 (PH1), Y1.3
unnamed: C35.2, U13.30 (VCAP_1)
unnamed: D15.2 (A), R46.1
unnamed: D16.2 (A), R42.2
unnamed: D17.2 (A), R43.2
unnamed: D18.2 (A), R49.1
unnamed: D19.2 (A), R50.1
unnamed: Q5.3 (D), R32.2, U13.61 (PB8)
unnamed: Q6.3 (D), R31.2, U13.62 (PB9)
unnamed: R19.1, U13.60 (BOOT0)

Notes on the sheet:
UNUSED_SPI1_SCK

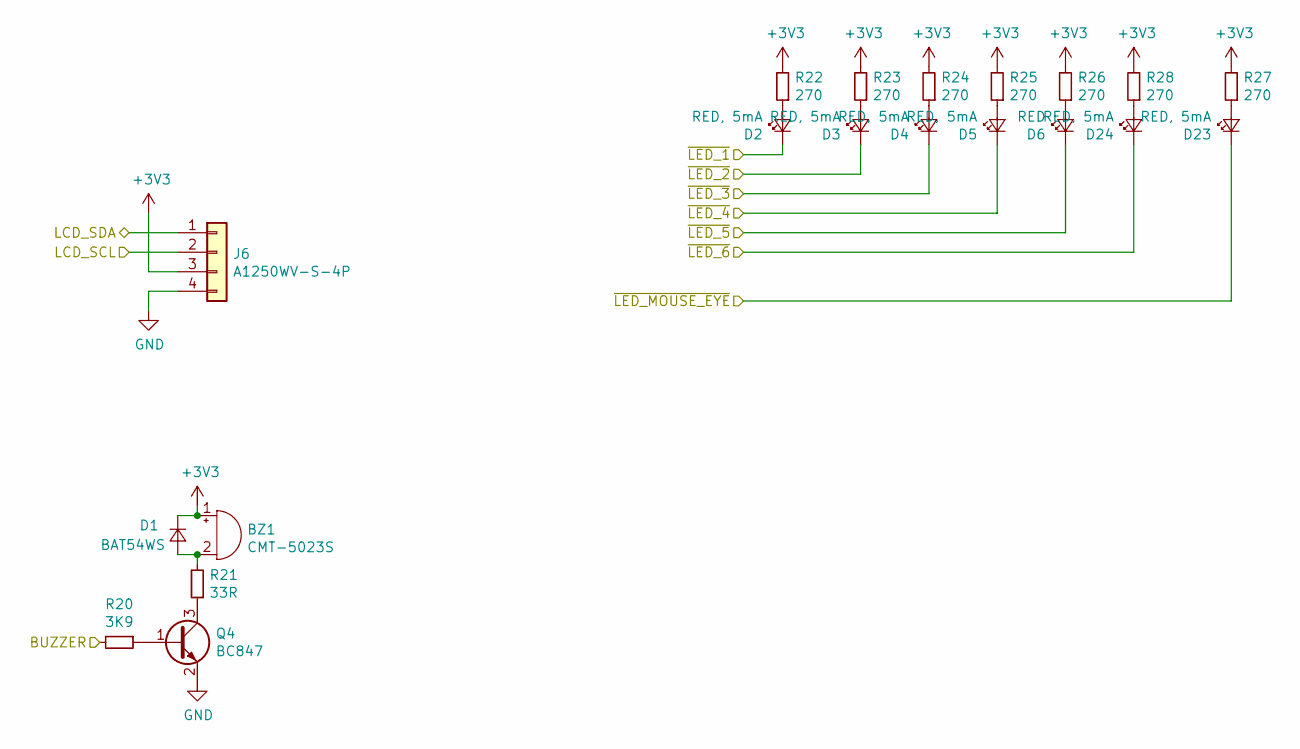
[picture p24: schematic LED & Oled & Buzzer.sch]

Parts:
BZ1: CMT-5023S; CMT5023SSMTTR
D1: BAT54WS; D_SOD-323
D2, D3, D4, D5, D23, D24: RED, 5mA; LED_0402_1005Metric
D6: RED; LED_0402_1005Metric
J6: A1250WV-S-4P; JST_GH_BM04B-GHS-TBT_1x04-1MP_P1.25mm_Vertical
Q4: BC847; SOT-23
R20: 3K9; R_0402_1005Metric
R21: 33R; R_0402_1005Metric
R22, R23, R24, R25, R26, R27, R28: 270; R_0402_1005Metric

Connections:
+3V3: BZ1.1 (-), D1.1 (K), J6.3, R22.2, R23.2, R24.2, R25.2, R26.2, R27.2, R28.2; also elsewhere on the board
/LED & Oled & Buzzer/BUZZER: R20.2; also elsewhere on the board
/LED & Oled & Buzzer/LCD_SCL: J6.2; also elsewhere on the board
/LED & Oled & Buzzer/LCD_SDA: J6.1; also elsewhere on the board
/LED & Oled & Buzzer/~LED_1: D2.1 (K); also elsewhere on the board
/LED & Oled & Buzzer/~LED_2: D3.1 (K); also elsewhere on the board
/LED & Oled & Buzzer/~LED_3: D4.1 (K); also elsewhere on the board
/LED & Oled & Buzzer/~LED_4: D5.1 (K); also elsewhere on the board
/LED & Oled & Buzzer/~LED_5: D6.1 (K); also elsewhere on the board
/LED & Oled & Buzzer/~LED_6: D24.1 (K); also elsewhere on the board
/LED & Oled & Buzzer/~LED_MOUSE_EYE: D23.1 (K); also elsewhere on the board
GND: J6.4, Q4.2 (E); also elsewhere on the board
unnamed: BZ1.2 (+), D1.2 (A), R21.2
unnamed: D2.2 (A), R22.1
unnamed: D3.2 (A), R23.1
unnamed: D4.2 (A), R24.1
unnamed: D5.2 (A), R25.1
unnamed: D6.2 (A), R26.1
unnamed: D23.2 (A), R27.1
unnamed: D24.2 (A), R28.1
unnamed: Q4.1 (B), R20.1
unnamed: Q4.3 (C), R21.1

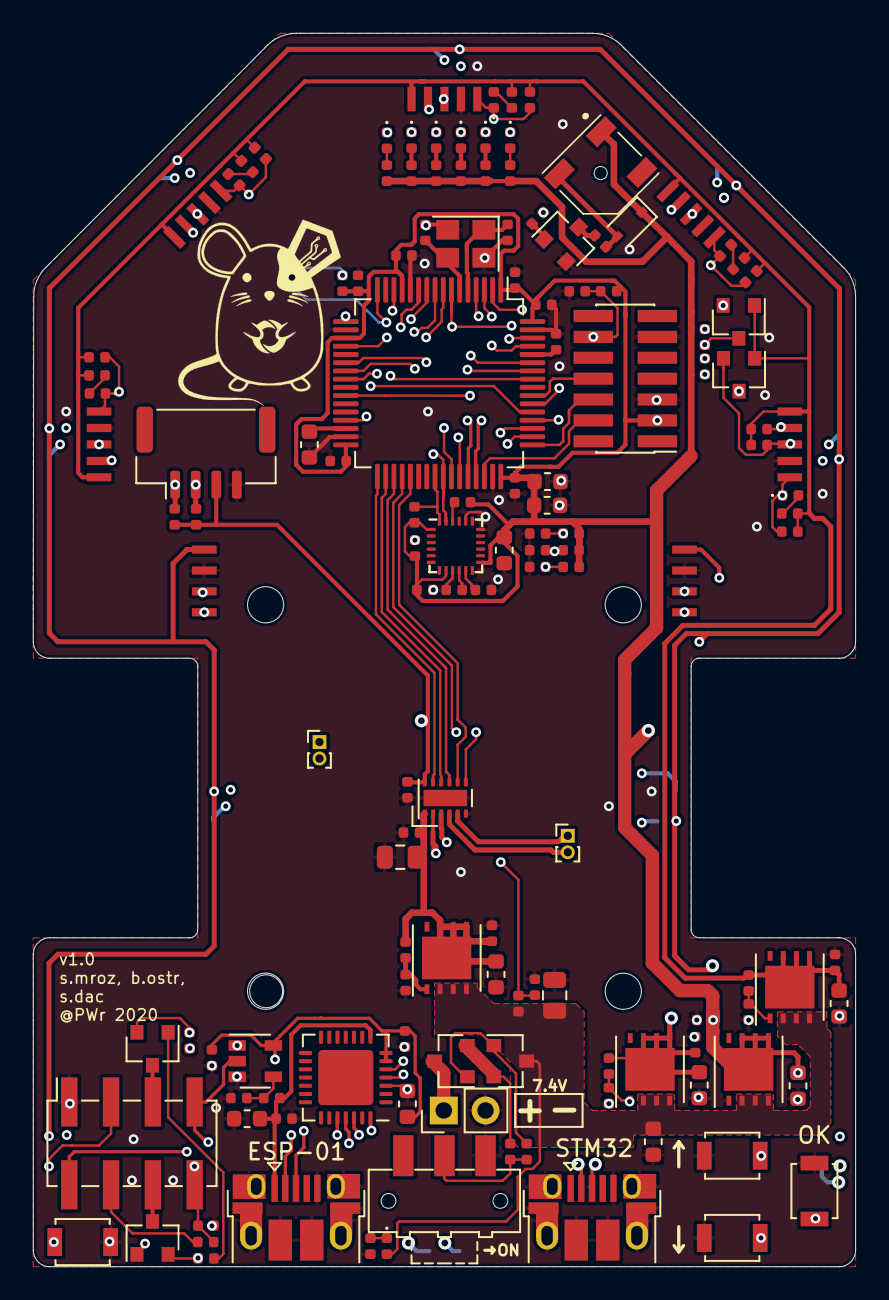
[picture p25: board synermycha-electronics.kicad_pcb from above]

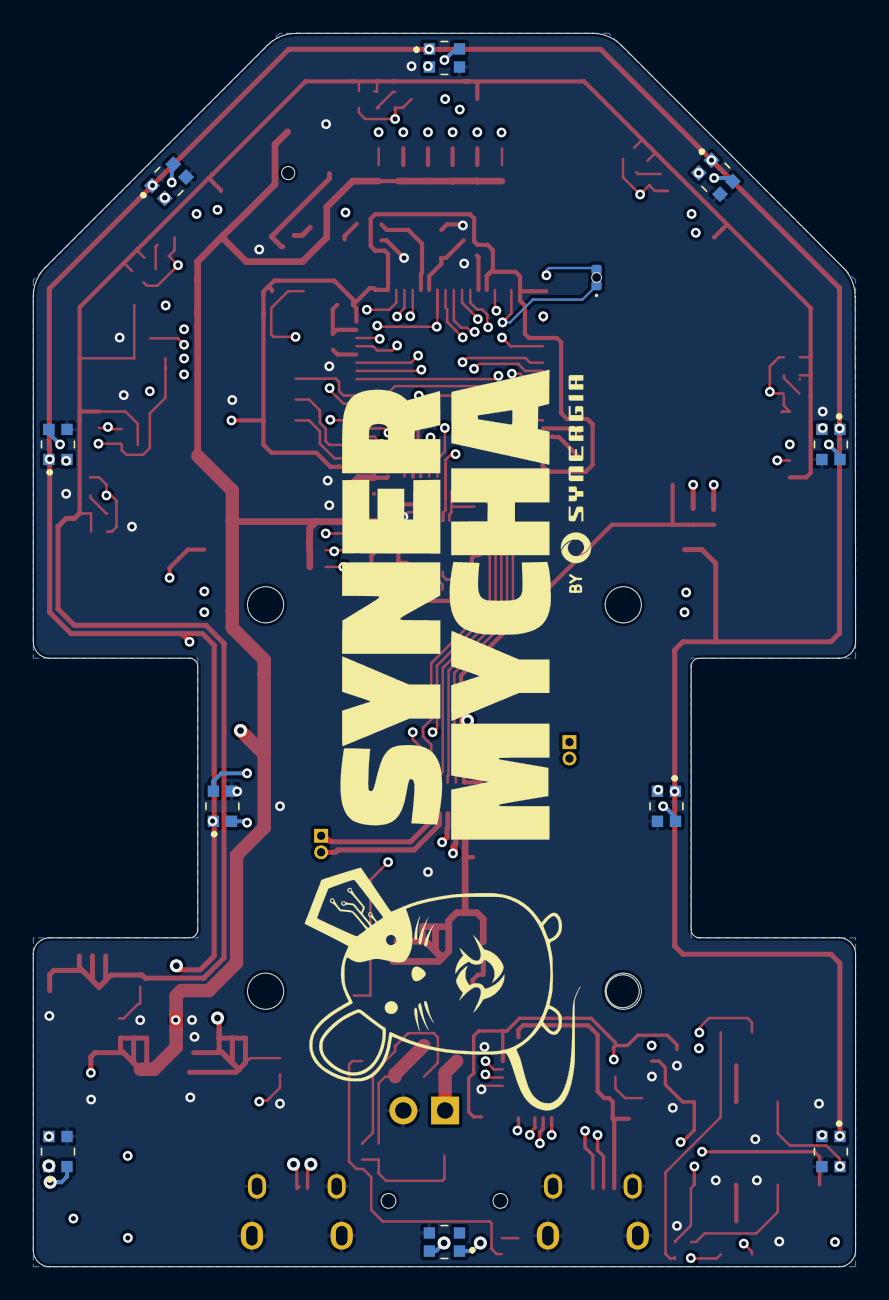
[picture p26: board synermycha-electronics.kicad_pcb from below]

Board: 4 copper layers, 50.0 x 75.0 mm, 149 parts (11 on the bottom side), 104 nets.
