synergia/synermycha-electronics/as5045b_board/as5045b_board.kicad_pcb

## KiCad design as5045b_board/as5045b_board.kicad_pcb (2020-03-10)

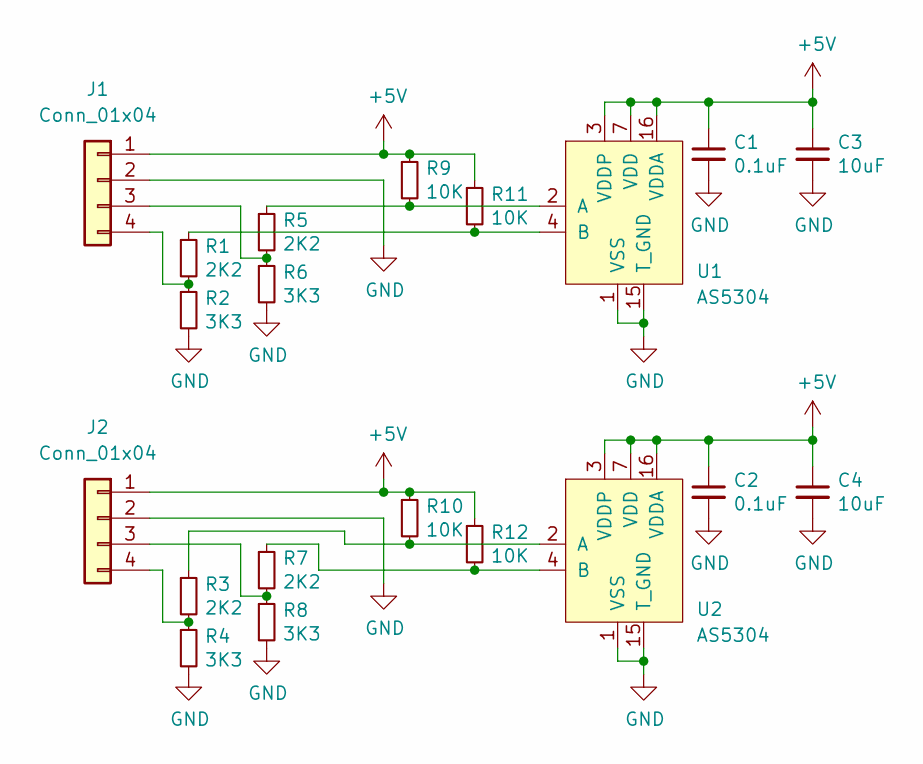
[picture p27: schematic as5045b_board.sch]

Parts:
C1, C2: 0.1uF; C_0402_1005Metric
C3, C4: 10uF; C_0603_1608Metric
J1, J2: Conn_01x04; 01x04_1.0x0.5mm_SMD
R1, R3, R5, R7: 2K2; R_0402_1005Metric
R2, R4, R6, R8: 3K3; R_0402_1005Metric
R9, R10, R11, R12: 10K; R_0402_1005Metric
U1, U2: AS5304; TSSOP-20_4.4x6.5mm_P0.65mm

Connections:
+5V: C1.1, C2.1, C3.1, C4.1, J1.1, J2.1, R9.1, R10.1, R11.1, R12.1, U1.3 (VDDP), U1.7 (VDD), U1.16 (VDDA), U2.3 (VDDP), U2.7 (VDD), U2.16 (VDDA)
GND: C1.2, C2.2, C3.2, C4.2, J1.2, J2.2, R2.2, R4.2, R6.2, R8.2, U1.1 (VSS), U1.15 (T_GND), U2.1 (VSS), U2.15 (T_GND)
unnamed: J1.3, R5.2, R6.1
unnamed: J1.4, R1.2, R2.1
unnamed: J2.3, R7.2, R8.1
unnamed: J2.4, R3.2, R4.1
unnamed: R1.1, R11.2, U1.4 (B)
unnamed: R5.1, R9.2, U1.2 (A)
unnamed: R3.1, R10.2, U2.2 (A)
unnamed: R7.1, R12.2, U2.4 (B)

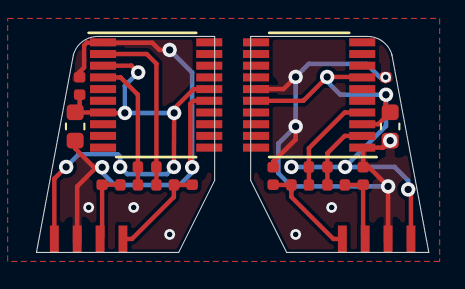
[picture p28: board as5045b_board.kicad_pcb from above]

Board: 4 copper layers, 21.8 x 12.0 mm, 20 parts (0 on the bottom side), 10 nets.
