synergia/synermycha-electronics/vl53l0_board/vl53l0_board.kicad_pcb

## KiCad design vl53l0_board/vl53l0_board.kicad_pcb (2020-03-10)

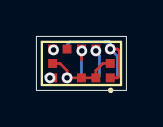
[picture p29: board vl53l0_board.kicad_pcb from above]

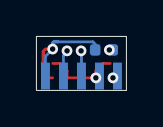
[picture p30: board vl53l0_board.kicad_pcb from below]

Board: 4 copper layers, 5.0 x 3.0 mm, 3 parts (2 on the bottom side), 6 nets.

Parts:
J17: Conn_01x05; 01x05_1.0x0.5mm_SMD
R13: 47K; R_0402_1005Metric
U7: VL53L0X; SENSOR_VL53L0X

Connections:
+2V8: J17.5, R13.1, U7.1, U7.11
/Distance Sensors/LOCAL_SCL: J17.4, U7.10
/Distance Sensors/LOCAL_SDA: J17.3, U7.9
/Distance Sensors/XSHUT_[3]: J17.1, U7.5
GND: J17.2, U7.2, U7.3, U7.4, U7.6, U7.12
unnamed: R13.2, U7.7
