synergia/synermycha-electronics/(commit log)

2020-03-01 Template schematic page
    [MainPCB.sch]
2020-03-01 Voltage sources, schematic division
2020-03-02 Board outline
    [MainPCB.brd]
2020-03-04 Moved to KiCad
    [ABM8G-12.000MHZ-4Y-T3--3DModel-STEP-56544.STEP, Buttonssch.sch, CMT-5023S-SMT-TR.stp, Distance Sensors.sch, Encoders.sch, IMU.sch, LED & Oled & Buzzer & IMU.sch, LED & Oled & Buzzer.sch]
2020-03-05 Major upgrade
    [Distance Sensors.sch, FTSH-107-01-L-DV-K-TR.stp, JS102011SAQN.STEP, LED & Oled & Buzzer.sch, Motors & Motors Drivers.sch, Power Section.sch, RGB.sch, User Library-R-PWSON-N12.step]
2020-03-05 Tweaks
    Swapped ENC_L and ENC_R pins, changed UART pins for STM32<->ESP connection, connected buzzer, LCD and IMU I2C lines were splitted and connected accordingly, added I2C pullup resistors
    [uController.sch]
2020-03-06 New footprint for OLED connector
    [LED & Oled & Buzzer.sch]
2020-03-06 Power on led
    [Power Section.sch]
2020-03-06 Many updates
    Added 3V3<->2V8 conversion for VC53L0x and leds for XSHUT of those. PCB update
    [synermycha-electronics.kicad_pcb, uController.sch]
2020-03-06 uC sch update
    [uController.sch]
2020-03-06 Changed connector for OLED
    [LED & Oled & Buzzer.sch]
2020-03-06 Added 2 RGB leds
    [RGB.sch]
2020-03-06 Adjusted connections, wiring almost finished
    [synermycha-electronics.kicad_pcb, uController.sch]
2020-03-06 Adjusted connections in uC schematics
    [uController.sch]
2020-03-06 Renamed vl53l0 project
    [vl53l0_board.kicad_pcb, vl53l0_board.sch]
2020-03-06 Added separate project for encoder boards
    [as5045b_board.kicad_pcb, as5045b_board.sch]
2020-03-06 Removed encoders from schematic as moved to the new project
    [Encoders.sch]
2020-03-06 PWR correction in RGB sch
    [RGB.sch]
2020-03-06 Clearing, added 3d model and Synermycha graphics
    [ABM8G-12.000MHZ-4Y-T3--3DModel-STEP-56544.STEP, CMT-5023S-SMT-TR.stp, DF13C-4P-1.25V.step, FTSH-107-01-L-DV-K-TR.stp, JS102011SAQN.STEP, MPU9250.step, User Library-R-PWSON-N12.step, VL53L0X.STEP]
2020-03-06 Changes in pcb traces names
    [synermycha-electronics.kicad_pcb]
2020-03-06 Replaced crystal symbol
    [uController.sch]
2020-03-06 Footprints update, save for cache.lib
2020-03-06 Added gnd via
    [synermycha-electronics.kicad_pcb]
2020-03-06 Added 3d model for motor mount and hole for mouse eye
    [mocowanie-napędów.stp]
2020-03-06 Added led
    [LED & Oled & Buzzer.sch]
2020-03-06 Added 5v rail
    [Power Section.sch]
2020-03-06 Added 2 more RGB leds
    [RGB.sch]
2020-03-06 Wired all electronics
    [uController.sch]
2020-03-06 Changes in wiring in main shematic
    [synermycha-electronics.sch]
2020-03-06 Minor tweaks and updates in settings
    [Motors & Motors Drivers.sch]
2020-03-06 Applied changes to PCB
    [synermycha-electronics.kicad_pcb]
2020-03-06 Added connection to RGB for STM32, remapped some pins
    [synermycha-electronics.kicad_pcb, synermycha-electronics.sch, uController.sch]
2020-03-07 Minor changes in pinout and layout
    [Buttonssch.sch, Distance Sensors.sch, Encoders.sch, IMU.sch, LED & Oled & Buzzer.sch, Motors & Motors Drivers.sch, Power Section.sch, RGB.sch]
2020-03-07 Changes in graphics, tweaks in power input, resistor values
    [Buttonssch.sch, Distance Sensors.sch, Encoders.sch, IMU.sch, LED & Oled & Buzzer.sch, Motors & Motors Drivers.sch, Power Section.sch, RGB.sch]
2020-03-07 Minor update in pin connections
    Connected Mouse eye led to PWM output
    [LED & Oled & Buzzer.sch, WiFi.sch, synermycha-electronics.kicad_pcb, uController.sch]
2020-03-07 Aesthetics update
    [synermycha-electronics.kicad_pcb]
2020-03-07 Sound emission hole
    [synermycha-electronics.kicad_pcb]
2020-03-07 Pinout matching with cube_mx
    [synermycha-electronics.kicad_pcb, uController.sch]
2020-03-07 Pinout matching ctn
    [synermycha-electronics.kicad_pcb]
2020-03-07 Resistor numbers and values
    [IMU.sch, Power Section.sch]
2020-03-07 Applying to PCB
    [synermycha-electronics.kicad_pcb]
2020-03-08 Changes in graphics, added capacitors, changes in xshut
    [Motors & Motors Drivers.sch, synermycha-electronics.kicad_pcb, uController.sch]
2020-03-09 Cosmetics update
    [synermycha-electronics.kicad_pcb]
2020-03-10 Finished encoders, added XSHUT pullups
    [Buttonssch.sch, Distance Sensors.sch, Encoders.sch, IMU.sch, LED & Oled & Buzzer.sch, Motors & Motors Drivers.sch, Power Section.sch, RGB.sch]
2020-03-10 Changed location of battery connector
    [synermycha-electronics.kicad_pcb]
2020-03-10 Flip led, fix path
    [LED & Oled & Buzzer.sch, synermycha-electronics.kicad_pcb]
2020-08-28 Odwrócono footprint prawego enkodera
    [synermycha-electronics.kicad_pcb]
